basimallawala/OverdrivePedal/OverdrivePedal.kicad_pcb

## KiCad design OverdrivePedal.kicad_pcb (2026-10-17)

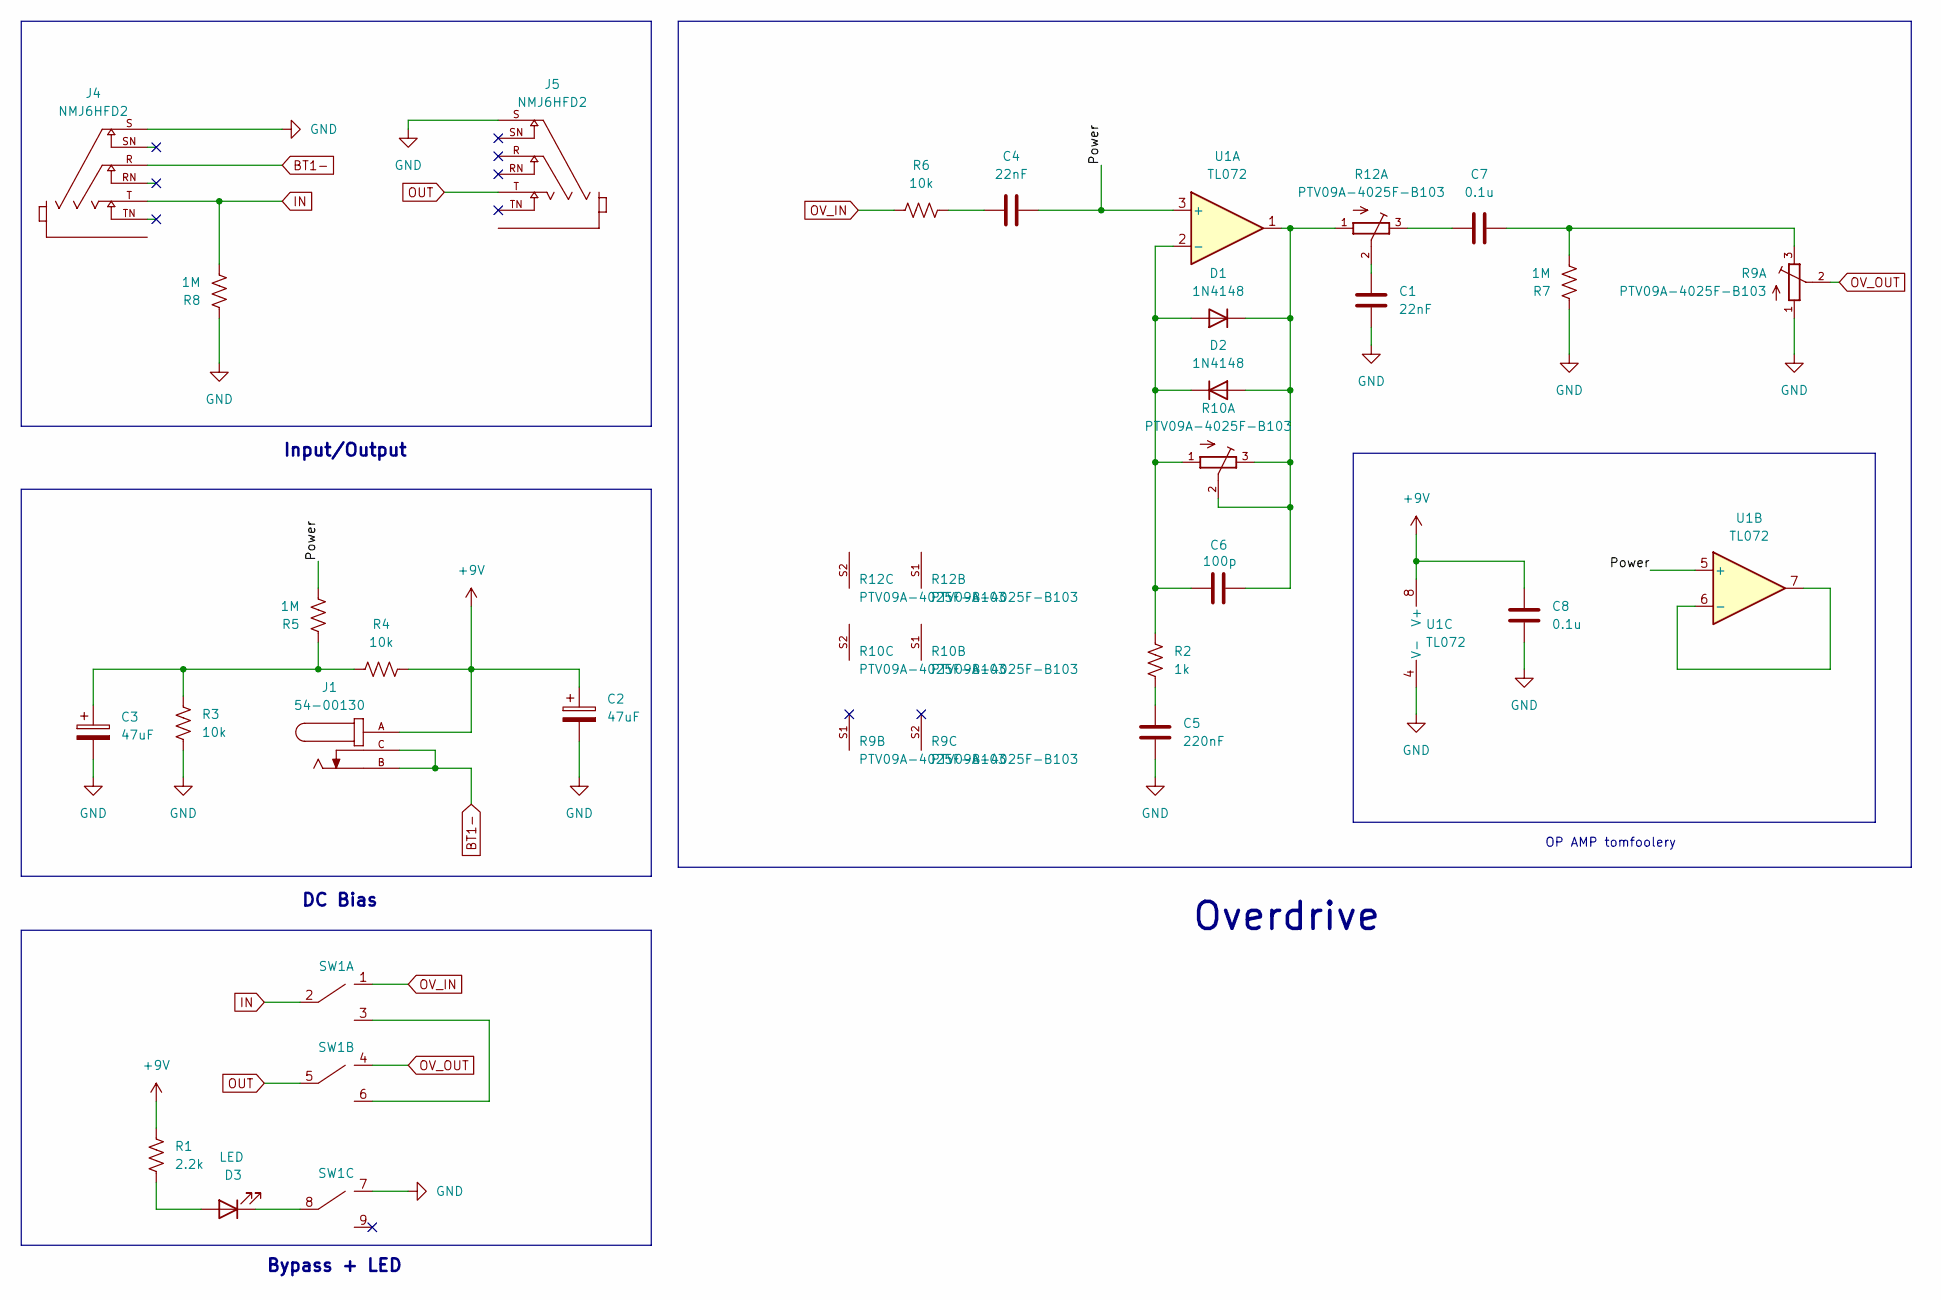
[picture p1: schematic OverdrivePedal.kicad_sch]

Parts:
C1, C4: 22nF; C_Disc_D5.0mm_W2.5mm_P5.00mm
C2, C3: 47uF; CP_Radial_D5.0mm_P2.00mm
C5: 220nF; C_Disc_D5.0mm_W2.5mm_P5.00mm
C6: 100p; C_Disc_D5.0mm_W2.5mm_P5.00mm
C7, C8: 0.1u; C_Disc_D5.0mm_W2.5mm_P5.00mm
D1, D2: 1N4148; D_DO-35_SOD27_P7.62mm_Horizontal
D3: LED; LED_D5.0mm
J1: 54-00130; TENSILITY_54-00130; PARTREV A
J4, J5: NMJ6HFD2; NEUTRIK_NMJ6HFD2; PARTREV 26.02.2021
R1: 2.2k; R_Axial_DIN0207_L6.3mm_D2.5mm_P10.16mm_Horizontal
R2: 1k; R_Axial_DIN0207_L6.3mm_D2.5mm_P10.16mm_Horizontal
R3, R4, R6: 10k; R_Axial_DIN0207_L6.3mm_D2.5mm_P10.16mm_Horizontal
R5, R7, R8: 1M; R_Axial_DIN0207_L6.3mm_D2.5mm_P10.16mm_Horizontal
R9, R10, R12: PTV09A-4025F-B103
SW1: PinSocket_1x09_P2.54mm_Vertical
U1: TL072; DIP-8_W7.62mm

Connections:
+9V: C2.1, C8.1, J1.A, R1.1, R4.2, U1.8 (V+)
/Power: C4.2, R5.1, U1.3 (+), U1.5 (+)
BT1-: J1.B, J1.C, J4.R
GND: C1.2, C2.2, C3.2, C5.2, C8.2, J4.S, J5.S, R3.2, R7.2, R8.2, R9.1, SW1.7, U1.4 (V-)
IN: J4.T, R8.1, SW1.2
unnamed: C1.1, R12.2
unnamed: C3.1, R3.1, R4.1, R5.2
unnamed: C4.1, R6.1
unnamed: C5.1, R2.2
unnamed: C7.1, R12.3
unnamed: C7.2, R7.1, R9.3
unnamed: C6.1, D1.2 (A), D2.1 (K), R2.1, R10.1, U1.2 (-)
unnamed: C6.2, D1.1 (K), D2.2 (A), R10.2, R10.3, R12.1, U1.1
unnamed: D3.2 (A), R1.2
unnamed: D3.1 (K), SW1.8
unnamed: SW1.3, SW1.6
unnamed: U1.6 (-), U1.7
OUT: J5.T, SW1.5
OV_IN: R6.2, SW1.1
OV_OUT: R9.2, SW1.4

Notes on the sheet:
OP AMP tomfoolery
Overdrive
Input/Output
Bypass + LED
DC Bias

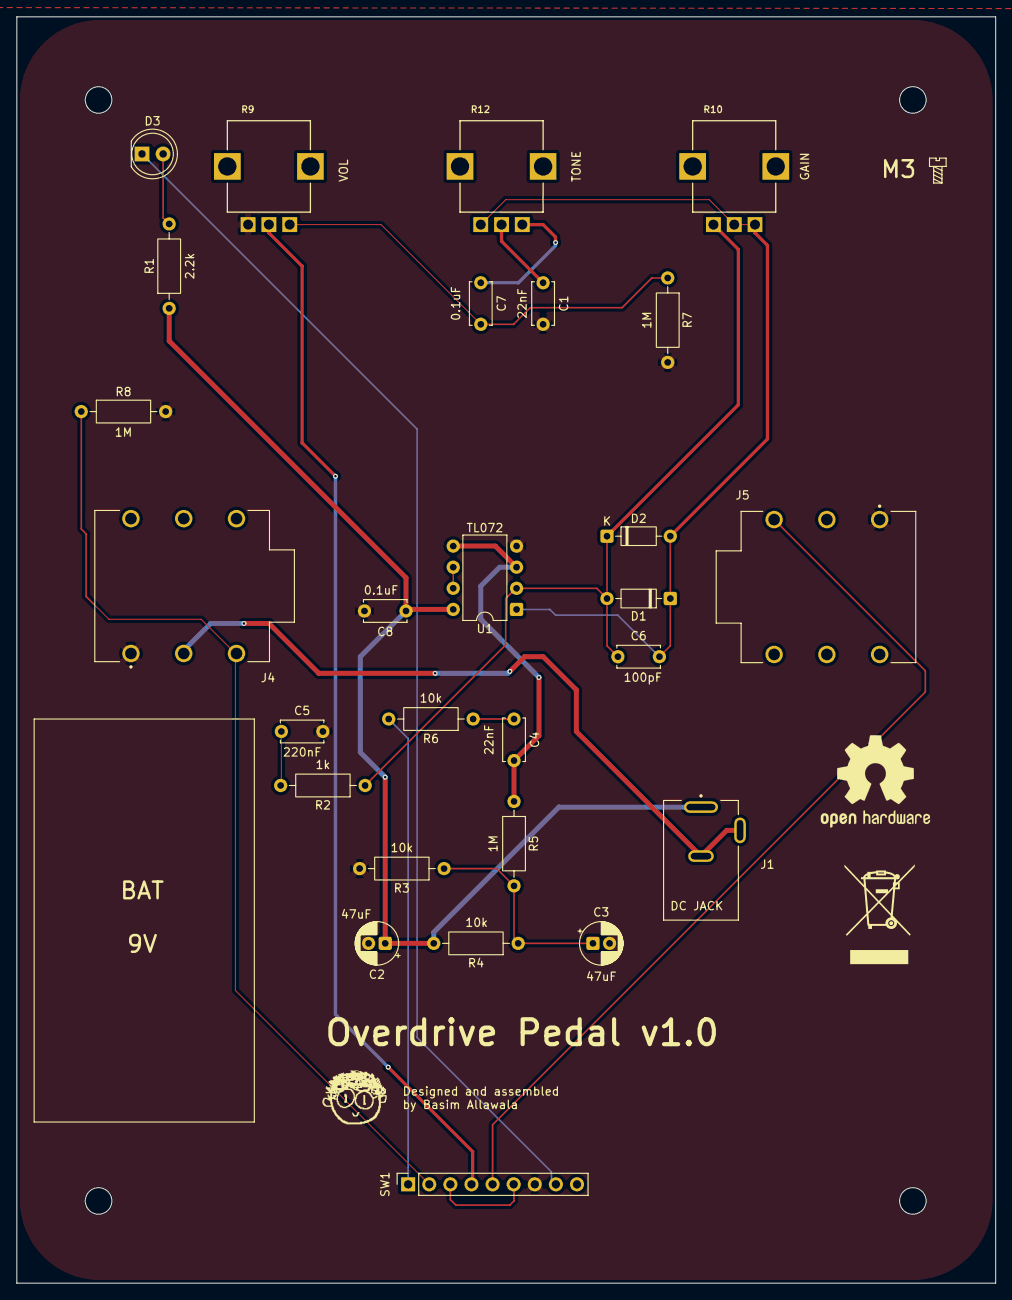
[picture p2: board OverdrivePedal.kicad_pcb from above]

Board: 4 copper layers, 117.8 x 152.4 mm, 27 parts (0 on the bottom side), 20 nets.
